ChuyX3/WTDesigner/DISEÑO Y SIMULACIÓN DE UN AEROGENERADOR DE BAJA POTENCIA (SWT)_2.docx

# DISEÑO Y SIMULACIÓN DE UN AEROGENERADOR DE BAJA POTENCIA (SWT)

## Resumen

La creciente tendencia en la instalación de turbinas eólicas de baja potencia en zonas urbanas ha creado un pequeño mercado para la industria y la investigación. En este documento se presenta el estudio energético para el diseño de un pequeño aerogenerador de uso urbano/doméstico. El diseño está basado según el estándar IEC 61400-2, de tipo de eje horizontal de álabes fijos con una potencia nominal de 5kW. Para la realización del análisis energético se utiliza el software de simulación TRNSYS con una base de datos del clima de diferentes zonas del país.

## Palabras Clave

Aerogenerador, SWT, Diseño, Optimización, Simulación, ANSYS, TRNSYS

## Nomenclatura

P_t | Potencia de salida del aerogenerador
P_w | Potencia total contenida en el viento
C_p | Coeficiente de potencia
ρ | Densidad del aire ( ≈1.225(kg)/(m^3) )
R | Radio del rotor
v | Velocidad del viento
λ | Razón de velocidad de la punta
ω_t | Velocidad angular del rotor
rpm | Velocidad angular del rotor en RPMs
v_u | Velocidad tangencial del rotor
v_r | Velocidad relativa del viento vista por el perfil alar
θ | Ángulo de ataque del viento relativo
α | Ángulo de ataque del perfil alar
β | Ángulo de control o “pitch”
L | Longitud local de cuerda
C_t | Torque mecánico suministrado al rotor

## I. INTRODUCCIÓN

En los últimos años ha habido un notable crecimiento en la instalación de aerogeneradores de baja potencia, con una capacidad de generación global de 830MW para finales del 2014 según [1]. También se estima que para el 2020 haya una capacidad instalada de 2000MW. Esta tendencia crea un pequeño mercado para la industria e investigación de pequeños aerogeneradores (SWT).

Sin embargo, en México hay un bajo desarrollo de esta tecnología. Según el informe del Programa de Desarrollo del Sistema Eléctrico Nacional (PRODESEN 2018) [2] nos indica que en México se ubican 45 centrales eólicas cuya capacidad instalada alcanza los 4,199 MW que representa el 6% de la capacidad total instalada, y que para el 2017 generaron un 3% del total nacional (10,620 GWh). A pesar de esto México tiene un potencial estimado de energía eólica de más de 40,000 MW considerando un factor de capacidad de 20-25% como lo indica la SENER [3], con lo cual podemos concluir que hay una gran capacidad de desarrollo para esta tecnología en nuestro país.

Algunas de las problemáticas presentes en los SWT son la ausencia en la optimización de los costos, deficiencia en la conversión eléctrica, pocos cuidados en la optimización del peso, cargas de diferentes naturalezas experimentadas por los SWT, álabes poco optimizados debido a seguir tendencias de los grandes aerogeneradores [4].

Un factor que también es importante para los SWT es que son diseñados para una velocidad de viento fija, a diferencia de los grandes aerogeneradores que tienen un control de “Pitch”, esto provoca que la mayoría del tiempo no opere en las condiciones de diseño, bajando así su rendimiento [5].

Otro problema que presentan es un bajo coeficiente de potencia ( C_p ) debido a un bajo rendimiento aerodinámico consecuencia de un bajo número de Reynolds. Los C_p para estos aerogeneradores es de alrededor de <(0.46-0.48) para un buen diseño de rotor, en contraposición a un C_p >0.50 para HAWT de gran tamaño (MWs) [6].

Con este trabajo se busca mejorar el coeficiente de potencia de un SWT en base a la optimización del álabe. Esto se pretende lograr mejorando el rendimiento aerodinámico por medio de cálculos matemáticos, así como optimizando el peso al utilizar materiales compuestos en la fabricación.

Este trabajo consta de cuatro etapas, la primera es el diseño geométrico por medio análisis matemático, la segunda es el diseño estructural con la ayuda de software CAD, la tercera es un análisis de elemento finito de tipo CFD y uno estático-estructural, y por último un análisis energético con ayuda de simulación.

## II. METODOLOGÍA

### II.1 Modelo Matemático.

La energía mecánica producida por el aerogenerador se puede calcular por la siguiente función [7]:

P_t =1/2∙C_p ∙ρ∙π∙R^2 ∙v^3

La razón entre la velocidad de la turbina y la velocidad del viento es expresad por lo siguiente [7]:

λ=(ω_t ∙R)/v

La velocidad tangencial del álabe está dada por la relación [8]:

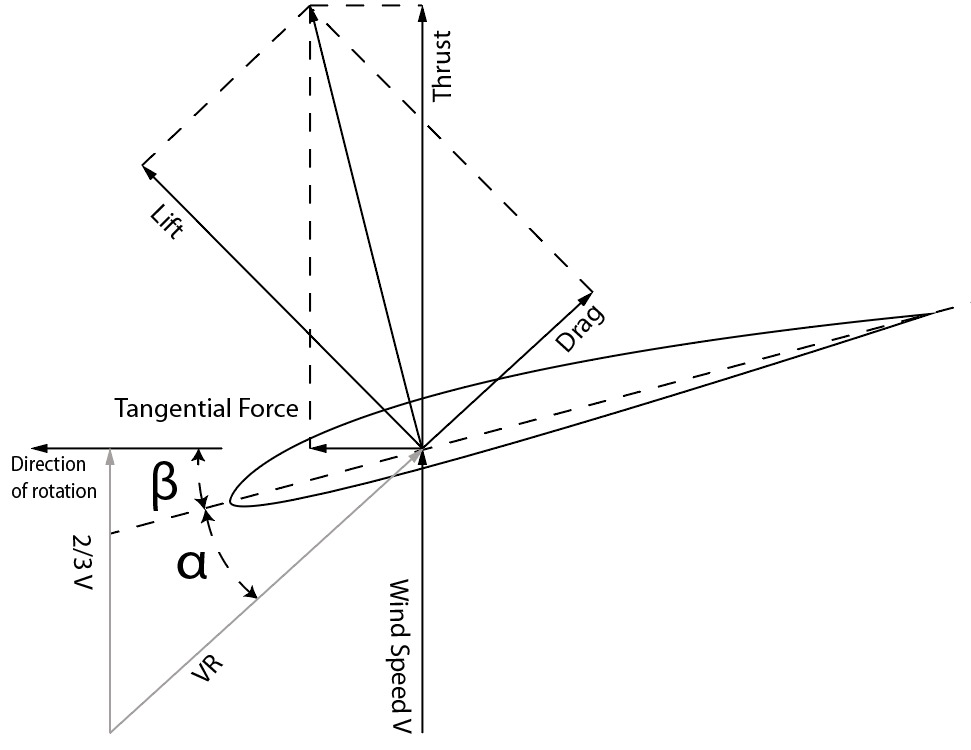
[picture p1: figure]

Figura 1: Fuerzas aerodinámicas actuando sobre un perfil alar.

v_u =(rpm∙π∙R)/30

La velocidad del viento vista desde el punto de vista del perfil alar está dada por [8]:

v_r =√((2/3v)^2 +v_u ^2)

A un ángulo de ataque [8]:

θ=tan^(-1) 2/(3λ)

El ángulo de ataque del perfil alar está dado por:

α=θ-β

Donde hay un β para cada punto a lo largo del álabe.

Para determinar las fuerzas aerodinámicas que actúan sobre el álabe es necesario obtener las gráficas de coeficiente de sustentación aerodinámica y coeficiente de arrastre del perfil alar. Para nuestro caso se utilizó el perfil alar A18.

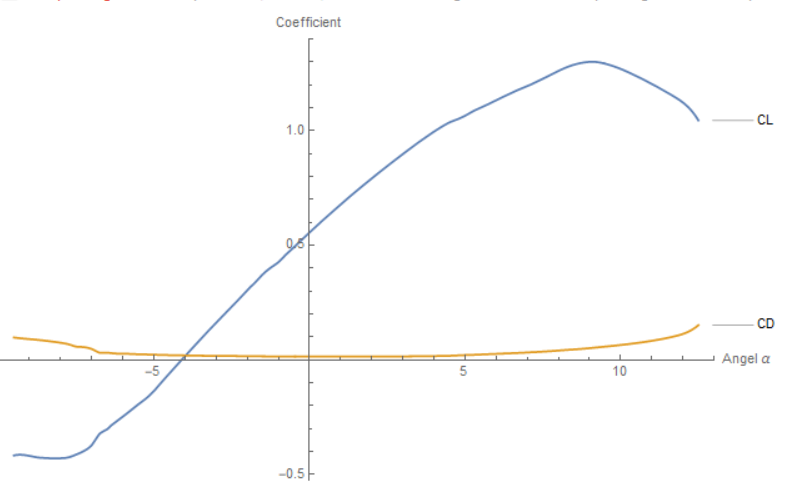
[picture p2: figure]

Gráfica 1: Coeficiente de sustentación aerodinámica (azul) y coeficiente de arrastre aerodinámico (amarillo) del perfil alar A18 para un número de Reynolds de 100,000 [9].

Para cada sección del álabe de longitud dr , hay una fuerza en dirección del viento relativo y una fuerza ortogonal, como lo muestra la figura 1, definidas por [10]:

F_(lift) =1/2C_L ∙ρ∙v_r ^2 ∙L∙dr

F_(drag) =1/2C_D ∙ρ∙v_r ^2 ∙L∙dr

Estas dos fuerzas pueden combinarse para obtener dos principales componentes, una ortogonal al plano de barrido y otra en dirección a la rotación.

F_(tangential) =F_(lift) ∙Sin(α)- F_(drag) ∙Cos(α)

F_(thrust) =F_(lift) ∙Cos(α)+ F_(drag) ∙Sin(α)

Para obtener el torque suministrado al rotor se tiene la siguiente expresión [10]:

C_t =∫_0^R (F_(tangential) ∙r) dr

Sustituyendo las ecuaciones anteriores de fuerzas en nuestra expresión de torque nos queda que:

C_t =ρ/2∫_0^R v_r ^2 L(C_L Sin(α)- C_D Cos(α))r dr

Donde v_r , L y α están en función de r (distancia de la sección del álabe al eje de rotación) y, C_L y C_D en función de α .

De igual manera se tiene que el empuje es:

Thrust=ρ/2∫_0^R v_r ^2 L(C_L Cos(α)+ C_D Sin(α))r dr

El cual se convierte en una carga dinámica estructural que debe ser considerada en el diseño mecánico.

Para obtener la potencia de salida se utiliza la siguiente ecuación [10]:

P_t =C_t ω_t

Para obtener el C_P se divide la potencia de salida por la potencia total contenida en el viento.

C_P =(P_t)/(P_w)

### II.2 Teoría de Elemento de Álabe (BET)

La teoría de momento de elemento de álabe es un método ampliamente utilizado y rápido en aplicaciones aerodinámicas y aeroelásticas de aerogeneradores. Por medio de este método se puede calcular rápidamente las fuerzas aerodinámicas que actúan sobre el álabe dividiéndolo en un número de secciones finitas de longitud dr y analizarlas independientemente [11][12].

De esta manera se puede definir la función del momento como:

C_t =ρ/2∑_(k=1)^n v_r ^2 L(C_L Sin(α)- C_D Cos(α))r dr

Donde:

n=número de secciones

dr=R/n

r=k dr

En base a esta ecuación podemos calcular analíticamente una aproximación de una curva idealizada de generación de energía en función de la velocidad del viento.

Para realizar el programa que se encarga de la resolución de las ecuaciones se ha utilizado el software matemático “Wolfram Mathematica”.

Cálculo de las secciones del álabe
Cálculo de la razón de velocidad para cada sección
Cálculo de la velocidad tangencial para cada sección
Cálculo de la velocidad relativa del viento para cada sección
Cálculo del ángulo de ataque para la mayor fuerza tangencial
Cálculo del ángulo del viento relativo para cada sección
Cálculo del ángulo de control (pitch) para cada sección
Cálculo de la longitud de cuerda para cada sección

Diagrama de Flujo 1: Secuencia utilizada por el programa en Mathematica para calcular los parámetros de la geometría del álabe

### II.3 Diseño CAD

En el diseño basado en características, se crean modelos de piezas. Para rediseñar una parte, se editan las características; sus descripciones se modifican y registran automáticamente por la interfaz de diseño y se compilan en serie por un compilador de diseño (operaciones de edición de características CAD). Los sistemas de modelado paramétrico basados en características generalmente definen modelos por un historial secuencial de pasos de modelado. Cada paso contiene operaciones y parámetros. Un modelador paramétrico es un sistema para el diseño geométrico que preserva no solo el objeto diseñado, sino también el conjunto de gestos constructivos utilizados para diseñarlo [13].

Para realizar el diseño del álabe se utiliza CATIA V5 el cual es un sistema CAD basado en características.

Primeramente se crean una serie de costillas con la geometría del perfil alar con una longitud de cuerda, ángulo y posición obtenidos en el cálculo matemático. Posterior mente se hace una superficie muilti-sección la cual será necesaria para el laminado de compuestos. Con esta superficie se crea un sólido que será utilizado en el análisis aerodinámico CFD.

### II.4 Diseño del Laminado de Compuestos

### II.5 Método De Elemento Finito (FEM)

#### II.5.1 Análisis CFD

Otro método para calcular el rendimiento de un aerogenerador es la dinámica de fluidos computacional (CFD). Dado que se espera que los modelos aerodinámicos de baja fidelidad como la teoría BEM sigan siendo el método de elección para los cálculos de carga industrial en el futuro previsible, los modelos numéricos de mayor fidelidad como la dinámica de fluidos computacional (CFD) se utilizan cada vez más para investigar fenómenos aerodinámicos relevantes para rotores grandes [14].

El CFD consiste en la solución numérica de las ecuaciones de control diferenciales de los flujos de fluidos con la ayuda de computadoras[15][16].

En el mercado hay una gran variedad de software para resolver estos cálculos, uno de ellos es ANSYS 19 CFX el cual es utilizado para este caso.

#### II.5.2 Análisis Estático-Estructural

Para realizar el análisis estático estructural se utilizará el método de elemento finito (FEM) con ayuda de la herramienta de software ANSYS 19.

Para realizar este análisis primeramente se carga la geometría en un sistema de análisis ACP(Pre) en una plantilla de trabajo de Workbench, en el cual se cargarán los laminados de compuesto.

En la misma plantilla de Workbench se carga un análisis estático estructural para definir las cargas y soportes. La carga se importa desde el análisis anterior CFD. El soporte es uno fijo al extremo del álabe.

Por último se agrega un análisis ACP(Post) donde se mostrarán los resultados del análisis estructural. Para ello hay que agregar dos soluciones, “Deformación” y “Factor de Seguridad” con criterio de máximo esfuerzo.

### II.6 Análisis Energético

TRNSYS es un entorno de simulación completo y extensible para el modelado transitorio de sistemas, incluidos edificios multizona. Es utilizado por ingenieros e investigadores de todo el mundo para validar nuevos conceptos de energía, desde simples sistemas de agua caliente doméstica hasta el diseño y simulación de edificios y sus equipos, incluyendo estrategias de control, comportamiento de los ocupantes, sistemas de energía alternativa (eólica, solar, fotovoltaica, sistemas de hidrógeno), etc.[17].

Para una simulación efectiva, la estructura modular de TRNSYS requiere la identificación de los componentes del sistema aplicables. Los componentes en el sistema TRNSYS se conocen como TYPE. Cada TYPE tiene un conjunto de parámetros independientes del tiempo, así como entradas variables en el tiempo que permiten la estimación de las salidas coincidentes.

Para este trabajo se utilizaron los siguientes types con el objetivo de simular el desempeño del aerogenerador que se está diseñando:

#### Type 90:

Es un modelo matemático para un sistema de conversión de energía eólica (WECS). El modelo calcula la salida de potencia de un WECS según una característica de potencia frente a la velocidad del viento (proporcionada en forma de tabla en un archivo externo). También se modela el impacto de los cambios de densidad del aire y los aumentos de velocidad del viento con la altura.

Las principales ecuaciones utilizadas en este modelo se basan en el trabajo de (Quinlan, 2000; Quinlan et al., 1996) [17].

#### Type 15:

Este componente sirve para leer datos a intervalos de tiempo regulares de un archivo de datos meteorológicos externos, los interpola (incluida la radiación solar para superficies inclinadas) en intervalos de tiempo de menos de una hora, y los pone a disposición de otros componentes de TRNSYS [17].

#### Type 65:

El componente de gráficos en línea se usa para mostrar las variables del sistema seleccionadas mientras la simulación avanza.

Este componente es altamente recomendado y se usa ampliamente, ya que proporciona información variable valiosa y permite a los usuarios ver inmediatamente si el sistema no está funcionando como se desea. Las variables seleccionadas se mostrarán en una ventana de trazado separada en la pantalla [17].

#### Type 24:

Este componente integra una serie de cantidades durante un período de tiempo. Cada integrador de cantidades puede tener hasta, pero no más de 500 entradas. Type24 puede reiniciarse periódicamente a lo largo de la simulación, ya sea después de un número específico de horas o después de cada mes del año [17].

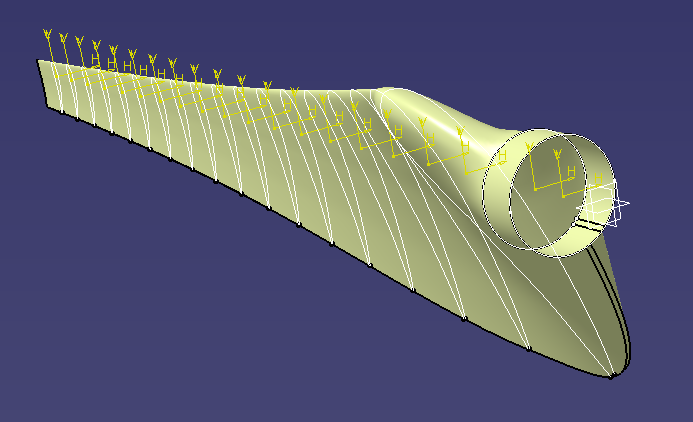
[picture p3: figure]

Figura2: Modelo del álabe creado en CATIA V5.

## III. RESULTADOS

### III.1 Diseño Geométrico y Análisis Matemático

Los parámetros de diseño utilizados para calcular la geometría de álabe se muestran en la tabla 1.

Parámetro | Valor | Descripción
P_D | 5kW | Potencia de salida
v_w | 10m/s | Velocidad del viento
Z | 3 | Número de álabes
ω_D | 200 RPM | Velocidad angular del rotor
N | 20 | Número de secciones para el BEM

Tabla 1: Parámetros de diseño para el rotor.

Los primeros datos arrojados por el programa son el radio del rotor R=2.55m y la razón de velocidad de la punta λ= 5.34 . Los datos de longitud de cuerda y ángulo giro (twist) se muestran en las gráficas 2 y 3.

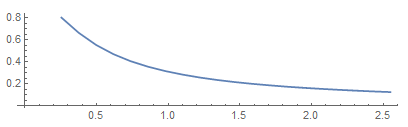
[picture p4: figure]

Gráfica 2: Gráfica de longitud de cuerda a lo largo del álabe.

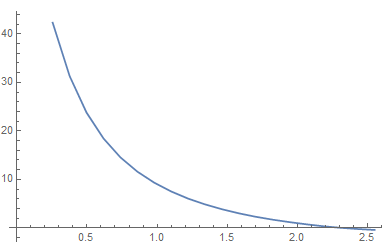
[picture p5: figure]

Gráfica 3: Gráfica de ángulo de control (pitch) a lo largo del álabe.

Con estos datos se pudo construir el álabe en CATIA V5. Primeramente se crearon las costillas con el perfil alar y las dimensiones (longitud de cuerda y ángulo) calculadas y después una superficie multisección.

### III.2 Análisis De Elemento Finito

## IV. CONCLUSIONES

## REFERENCIAS

[1] http://www.sener.gob.mx/res/PE_y_DT/pub/2014/Prospectiva_Energias_Reno_13-2027.pdf
[2] Energía, S. (2018). Programa de Desarrollo del Sistema Eléctrico Nacional. Retrieved from https://www.gob.mx/sener/acciones-y-programas/programa-de-desarrollo-del-sistema-electrico-nacional-33462.
[3] Secretaría de Energía (SENER). (2013). Prospectiva de Energías Renovables 2013–2027, SENER, México.
[4] Bukala J, Damaziak K, Kroszczynski K, Malachowski J, Szafranski T, Tomaszewski M, Karimi H, Jozwik K, Karczewski M & Sobczak K. (2016). Small Wind Turbines: Specification, Design, and Economic Evaluation. Wind Turbines (Chapter 4). Rijeka: IntechOpen.
[5] Battisti L, Benini E, Brighenti A, Dell’Anna S & Raciti Castelli M. (2018). Small wind turbine effectiveness in the urban environment. Renewable Energy. Volume 129, Part A. pp 102-113
[6] Probst O, Martínez J, Elizondo J & Monroy O. (2011). Small Wind Turbine Technology. 10.5772/15861.
[7] Mefteh W. (2018). Simulation-Based Design:Overview about related works, Mathematics and Computers in Simulation. Volume 152, Pages 81-97, ISSN 0378-4754.
[8] Renouard H & Hau E. (2006). Wind Turbines Fundamentals, Technologies, Application, Economics. Dipl.-Ing. Frühlingstraße 21KraillingGermany: Springer.
[9] http://airfoiltools.com/airfoil/details?airfoil=a18-il
[10] Rosales P. (2014). Estudio de un aerogenerador de baja capacidad en condiciones de arranque. Universidad Autónoma de México. Mexicali, B.C., México.
[11] C.R. Vogel, R.H.J. Willden, G.T. Houlsby, Blade element momentum theory for a tidal turbine, Ocean Engineering, Volume 169, 2018, Pages 215-226, ISSN 0029-8018.
[12] Faisal Mahmuddin, Rotor Blade Performance Analysis with Blade Element Momentum Theory, Energy Procedia, Volume 105, 2017, Pages 1123-1129, ISSN 1876-6102.
[13] Farjana S & Han S. (2018). Mechanisms of Persistent Identification of Topological Entities in CAD Systems: A Review. Alexandria Engineering Journal. ISSN 1110-0168
[14] Dose B, Rahimi H, Herráez I, Stoevesandt B & Peinke J. (2018). Fluid-structure coupled computations of the NREL 5 MW wind turbine by means of CFD. Renewable Energy. Volume 129, Part A. pp 591-605. ISSN 0960-1481
[15] A Mekhail T, Abdel-Fadeel W & Mohammed W. (2015). Experimental and CFD of Designed Small Wind Turbine. International Journal of Scientific and Engineering Research. 6.
[16] Arteaga-López E, Ángeles-Camacho C & Bañuelos-Ruedas F. (2019). Advanced methodology for feasibility studies on building-mounted wind turbines installation in urban environment: Applying CFD analysis. Energy. Volume 167. PP 181-188. ISSN 0360-5442
[17] Reference Manual. (n.d.). Trnsys 17, 4. Trnsys 17. (n.d.), 2.
