ChuyX3/WTDesigner/Protocolo de Tesis Presentación.pptx

## DISEÑO Y ANÁLISIS DE UN ÁLABE UTILIZANDO MATERIALES COMPUESTOS PARA UN AEROGENERADOR DE USO DOMÉSTICO

UNIVERSIDAD AUTÓNOMA DE BAJA CALIFORNIA
FACULTAD DE INGENIERÍA

Presenta: Ing. Jesús Ángel Rocha Morales

Director: Dr. Alexis Acuña Ramírez
Co-Director: Mtro. Omar Alejandro Mata Lucero

Diciembre 2018

## Resumen

En este trabajo se presenta el estudio matemático, estructural y energético para el diseño de un álabe para un pequeño aerogenerador (Small Wind Turbine: SWT) de uso doméstico y sub-urbano.

1

## Contexto Global

En los últimos años ha habido un notable crecimiento en la instalación de aerogeneradores de baja potencia, con una capacidad de generación global de 830MW para finales del 2014 según [1].
También se estima que para el 2020 haya una capacidad instalada de 2000MW. Esta tendencia crea un pequeño mercado para la industria e investigación de pequeños aerogeneradores .

## Problemática Energética

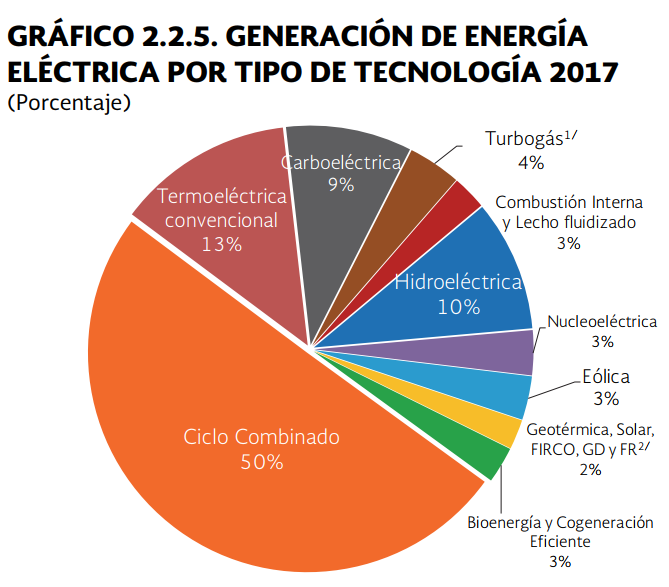
[picture p6: figure]

Fuentes de energía en México para el año 2018 [4].

- Estudios realizados por el Laboratorio de Energías Renovables del Departamento de Energía de Estados Unidos, CFE y varias instituciones mexicanas han estimado un potencial eólico de más de 40,000 MW en México, distribuido a lo largo de la península de Baja California, la región central, la costa del Golfo, la península de Yucatán y el istmo de Tehuantepec [2].
- La energía eólica es una de las alternativas más factibles en el corto y mediano plazo [2].
- A pesar de esto México ha instalado menos energía eólica en comparación con otros países de América del Norte [3].

2

## Problemática

Aerodinámica: Álabe mal optimizado que a menudo utiliza tendencias y observaciones de HAWT grandes, problema mal abordado de la abundancia de los recursos eólicos locales.
Bajo rendimiento aerodinámico por bajo número de Reynolds (<100,000) causa directa de bajo coeficiente de potencia (Cp<0.46-0.48) comparado con los grandes aerogeneradores (Cp > 0.50)
Estructural: diferente naturaleza de las cargas experimentadas por los SWT, poca atención a la optimización del peso;
Conversión / control: rara vez se utilizan métodos de regulación activa, como el control de rpm para expandir el margen operativo de los SWT, se presta poca atención a la capacidad de potencia mecánica de la turbina con la de un generador.
Económico: falta de costos optimizados de SWTs

## Objetivo general

- Diseñar un perfil alar con materiales compuestos para un pequeño aerogenerador por medio un análisis teórico y experimental.

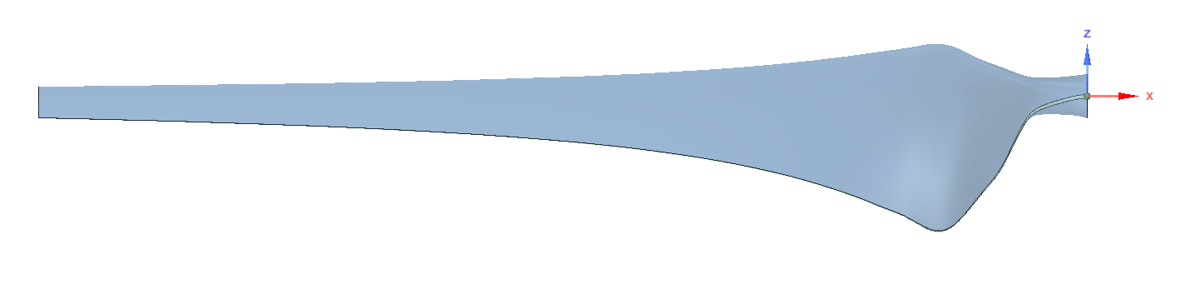
[picture p7: figure]

Álabe con perfil alar A18.

6

## Objetivos específicos

1
Investigar los diferentes perfiles alares más usuales en el mercado para los SWT, y los materiales para su fabricación.
2
Seleccionar los perfiles alares y materiales con los cuales se hará el análisis teórico y construcción del prototipo
3
Diseñar un álabe geométricamente optimizado

7

## Objetivos específicos

4
5
Análisis Energético
6
Análisis Estructural por elemento finito
Realizar un diseño estructural del álabe con materiales compuesto.

9

## Hipótesis

Con la selección correcta del perfil alar, un diseño matemáticamente optimizado y la utilización de materiales compuestos para el diseño de los álabes se puede mejorar el rendimiento de aerogeneradores de baja potencia SWT.

10

## Metodología

- Estudio del estado del arte de aerogeneradores.
- Estudio del estado del arte de perfiles alares.
- Estudio del estado del arte de materiales compuestos.
- Seleccionar los perfiles alares a los que se les hará el análisis teórico.
- Investigación sobre modelado matemático
- Investigación sobre herramientas de software para diseño y simulación
- Seleccionar los materiales a utilizar en el análisis teórico.
- Análisis teórico
- Construcción
- Experimentación
- Conclusiones

11

## Resultados: Uso de software

- Elemento Finito: ANSYS
  - Análisis estructural
  - Análisis térmico
  - Análisis de fluidos
  - Análisis modal
  - Análisis de fatiga
- CAD: Catia
  - Modelado 3D
- Matemáticas: Wolframe Mathematica
  - Cálculo de ecuaciones complejas y creación de plantillas
- Simulación Energética:
  - TRNSYS

## Resultados: Materiales Compuestos

- Propiedades en compuestos
  - Tienen una alta rigidez y resistencia específica orientadas a las fibras
  - La resistencia a la fatiga es mucho mayor para los materiales compuestos.
  - Ofrecen una alta resistencia a la corrosión.
  - Integración de piezas
  - Ofrecen mayores cantidades de flexibilidad de diseño
- Técnicas de Manofactura:
  - Hand Lay-up
  - Vacuum-bagging
  - Resin Infusion

## Resultados: Selección de Perfiles Alares

BW-3

- A18

SG6043

NACA6409

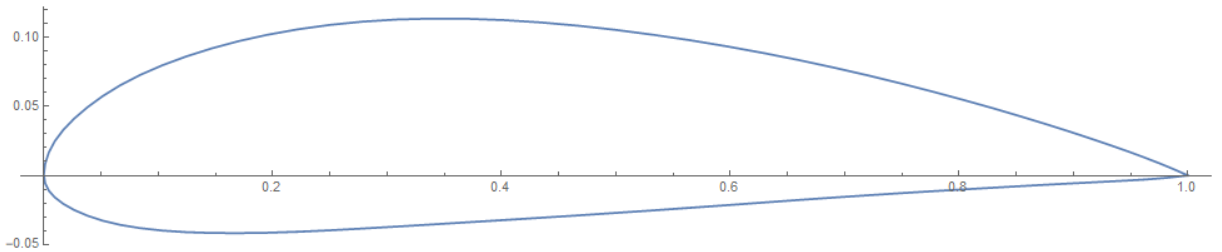
[picture p8: figure]

NACA4415

13

## Resultados: Diseño Matemático

- Modelo Matemático

Densidad del Aire: δ_a =1.225(Kg)/(m^3)

Potencia del Aire: Pw(v_W , R, C_P )= 1/2 C_P δ_a v_W ^3 R^2 π

Radio del Rotor: R (P_O , v_W , C_P )=√((2 P_O)/(C_P δ_a v_W ^3 π))

Razón de velocidad de la punta ( λ ): T SR(v_W , rpm, R)=(R rpm π)/(30 v_W)

Revoluciones Por Minuto: RPM (v_W ,λ, R)=(λ 30 v_W)/(R π)

## Resultados: Diseño Matemático

Modelo Matemático


Velocidades y fuerzas aerodinámicas

Velocidad Tangencial: v_U (R, rpm)= (R rpm π)/30

Velocidad Relativa: v_r (v_W , v_U )=√((2/3 v_W )^2 +v_U ^2)

Ángulo v_r (θ): theta(λ)=tan^(−1) 2/(3λ)

Longitud de la cuerda: ChordLength(R,v_W ,Z,C_L , λ,v_r )=(2 π R)/Z 8/(9 C_L) (v_W)/(λ v_r)

## Resultados: Diseño Matemático

Cálculos iniciales

v_W =15 m/s

P_O =5000W

R_1 =1.31 m
λ_d =6.86
Δ_R =0.0620526 m

RPM=750

Z=3

N_R =20

## Resultados: Diseño Matemático

Características del Álabe
A18

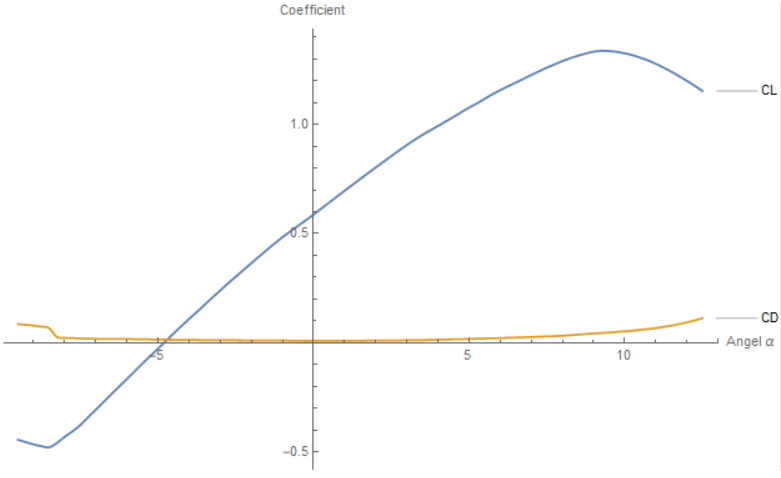
[picture p9: figure]

CL y CD en función del ángulo α

Coeficiente de sustentación: C_L (α)

Coeficiente de arrastre: C_D (α)

## Resultados: Diseño Matemático

Cálculo de los Parámetros de Diseño

R_(bls) =Table[x,{x, R −Δ_R (N_R −1),R,Δ_R }]
R_bls=Table[x,{x, R −Δ_R (N_R −1),R,Δ_R}]
λ_(rls) =(λ_d R_(bls))/R
λ_rls=(λ_d R_bls)/R
v_(uls) =v_u (R_(bls) , rpm)
v_uls=v_u (R_bls, rpm)
v_(rls) =v_r (v_w , v_(uls) )
v_rls=v_r (v_w, v_uls )
α_(ls) =FindMaximum(C_(FT) (α,λ_(rls) ), α)
α_ls=FindMaximum(C_FT (α,λ_rls ), α)
θ_(ls) =theta(λ_(rls) )
θ_ls=tℎeta(λ_rls )
θ_(ls) =θ_(ls) − α_(ls)
θ_ls=θ_ls − α_ls
l_(ls) =ChordLength(
R_(bls) ,v_W , Z, C_L (α_(ls) ),λ_(rls) ,v_(rls) )
l_ls=CℎordLengtℎ(
R_bls,v_W, Z, C_L (α_ls ),λ_rls,v_rls )

## Resultados: Diseño Matemático

Resultados de Diseño

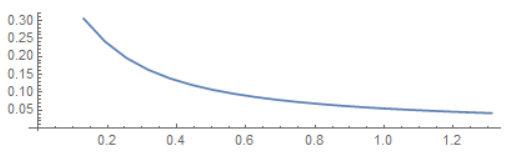
[picture p10: figure]

Gráfica de la longitud de cuerda

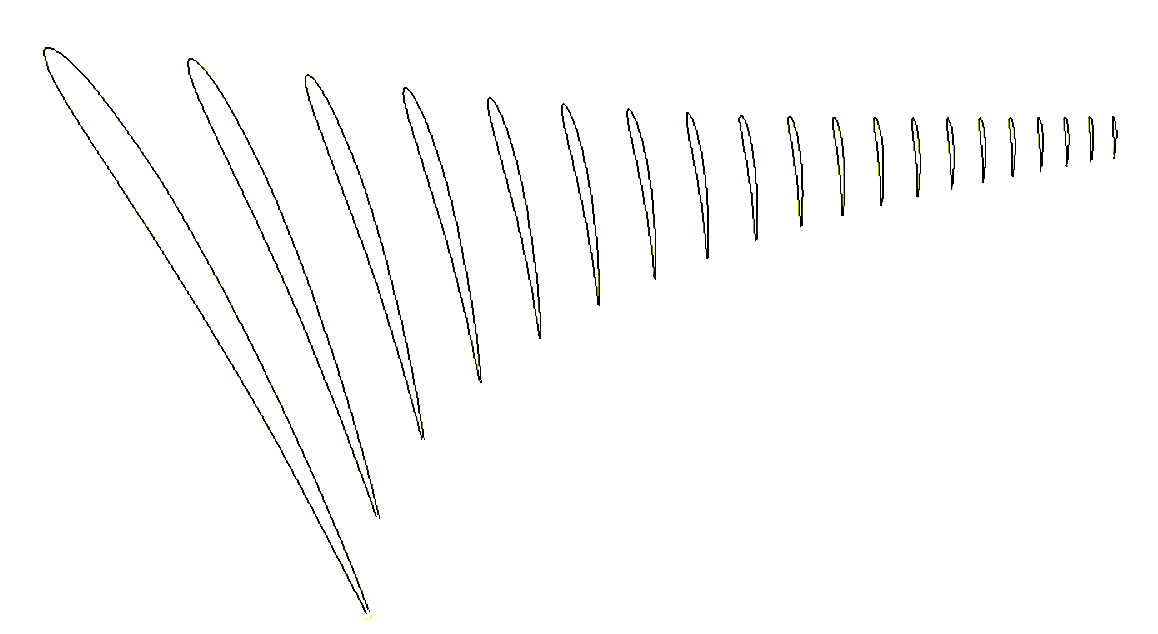
[picture p11: figure]

Perfil alar para cada longitud y ángulo calculado

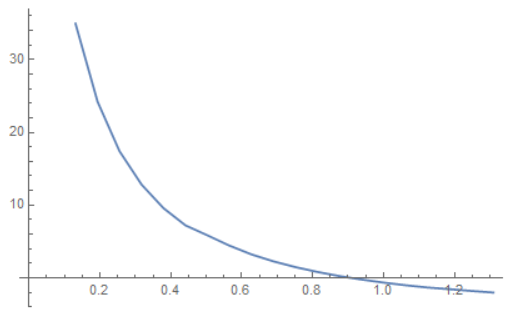
[picture p12: figure]

Gráfica del ángulo de control (Pitch)

## Resultados: Diseño Matemático

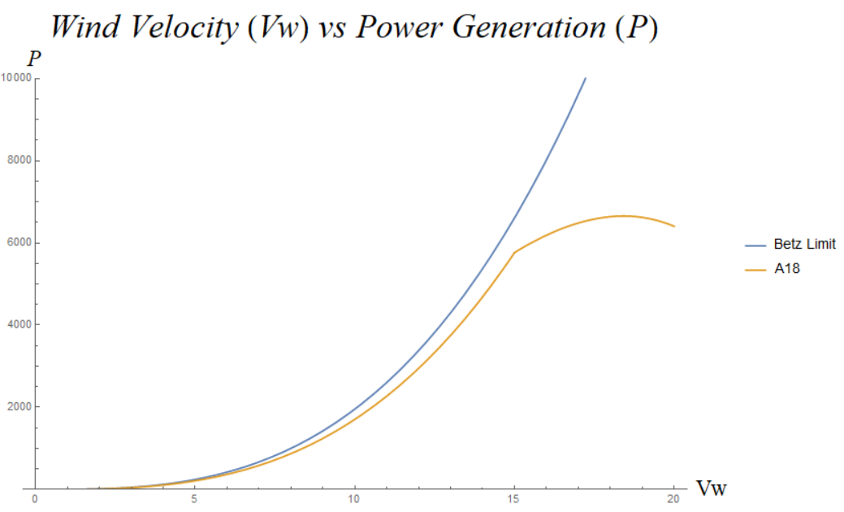
[picture p13: figure]

Fuerza Aerodinámica:
F_T (α,λ,v_r ,l, dr)= 1/2C_(FT) (α,λ)δ_a v_r ^2 l dr

Velocidad de viento contra Generación de potencia.

Resultados de Potencia

Potencia de Salida:
P_O (v_W )={(Zπ)/30RPM(v_W ) ∑ (F_T R_(b2) ),RPM(v_W )≤rpm_(max) (Zπ)/30rpm_(max) ∑ (F_T R_(b2) ),RPM(v_W )>rpm_(max) }

Coeficiente de Conversión de Potencia:
C_P (v_W )=P_O (v_W )/P_W (v_W ) = 0.516967

## Resultados: Diseño 3D

Modelado de Superficie

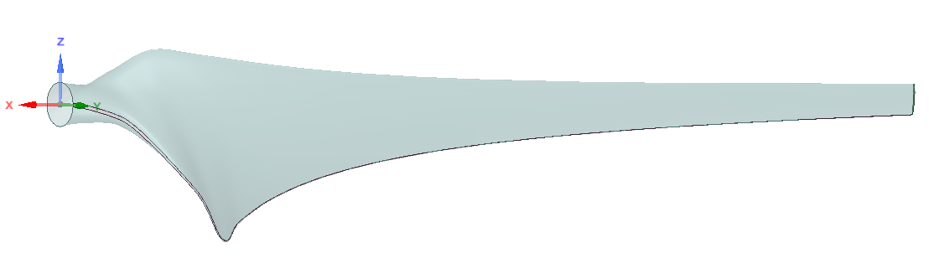
[picture p14: figure]

Diseño de superficie en CATIA.

## Resultados: Análisis Estructural

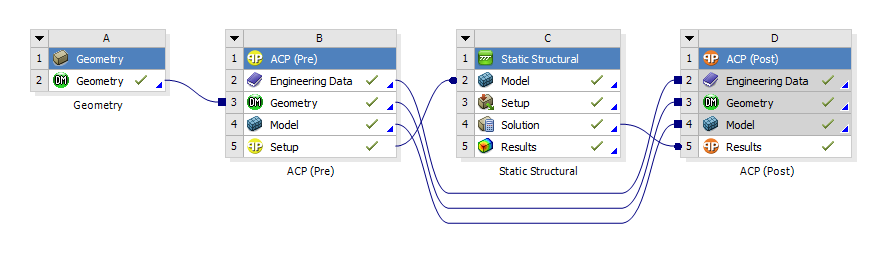
[picture p15: figure]

Hoja de trabajo en Workbench

Diagrama de Flujo del Análisis

## Resultados: Análisis Energético

ACP (Pre)

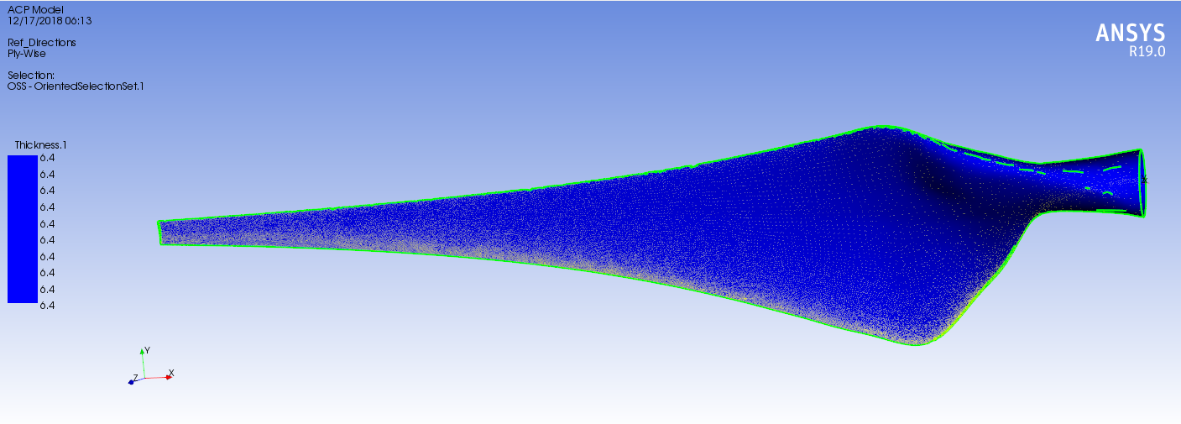
[picture p16: figure]

Diseño de superficie en CATIA.

## Resultados: Análisis Estructural

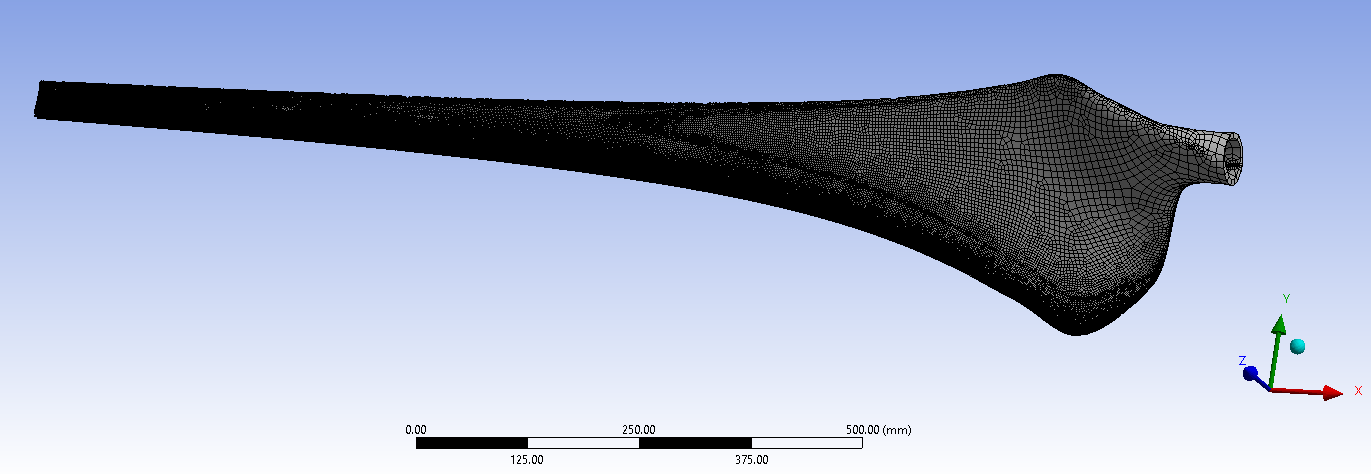
[picture p17: figure]

Mesh del álabe en Mechanical.

Static Structural

## Resultados: Análisis Estructural

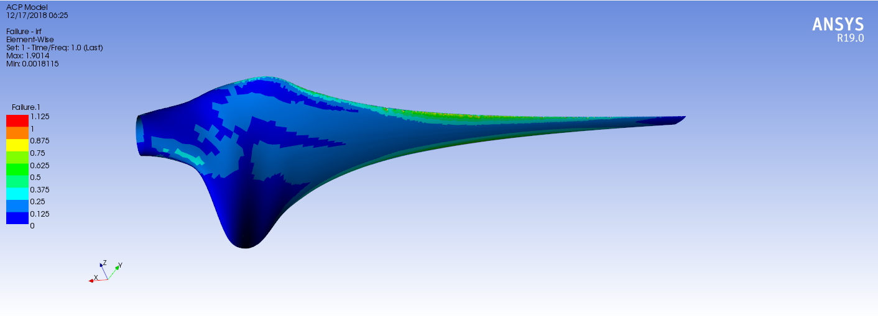
[picture p18: figure]

Diseño de superficie en CATIA.

ACP(Post)

## Resultados: Análisis Energético

TRNSYS

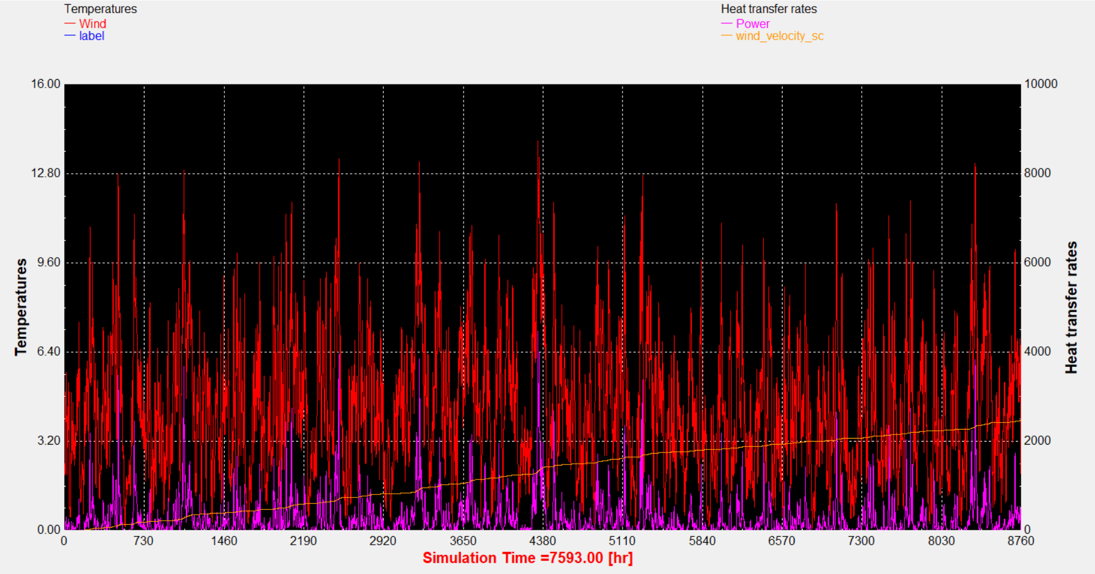
[picture p19: figure]

Diseño de superficie en CATIA.

2474kW Anual

## Resultados: Análisis Energético

TRNSYS

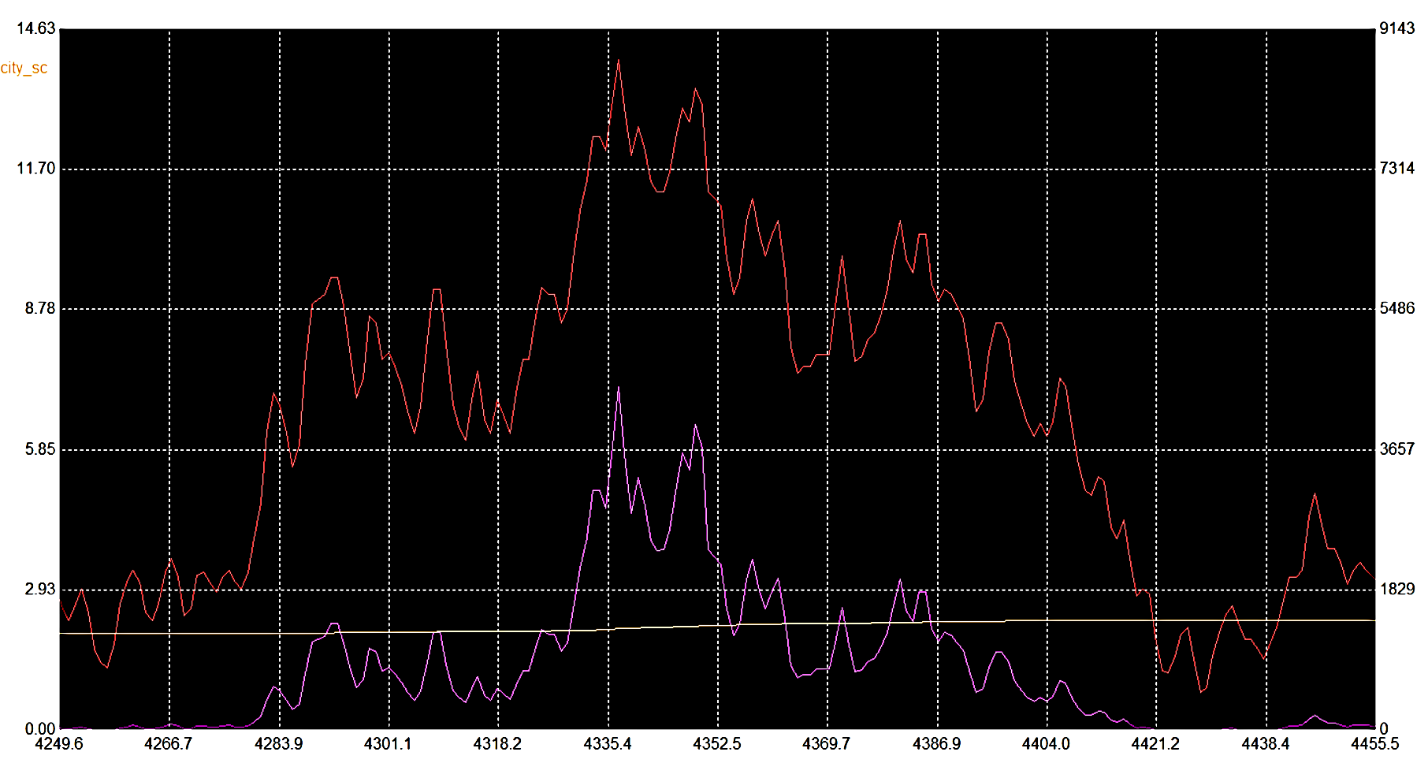
[picture p20: figure]

Diseño de superficie en CATIA.

13.97 m/s

4.454kW

5.338kW

CP = 0.4947

## Cronograma

Actividad | 17-2 | 18 - 1 | 18 -2 | 19 - 1 | Descripción
Estado del arte de aerogeneradores | X | X | | | Hacer una búsqueda de los aerogeneradores disponibles en el mercado
Estado del arte de materiales compuestos | X | X | | | Hacer una investigación acerca de los materiales compuestos disponibles en el mercado para la construcción del perfil alar
Estado del arte de perfiles alares | X | X | | | Hacer una investigación acerca de los perfiles alares disponibles en el mercado
Selección los perfiles alares | | X | x | | Seleccionar los perfiles alares a los que se les hará el análisis teórico
Investigación sobre modelado matemático | | X | X | | Hacer una investigación acerca de los métodos utilizados para el modelado matemático y cálculo de esfuerzos a los que se ve sometido el perfil alar
Investigación sobre herramientas de software | | X | X
Selección de materiales | | X | x | | Se seleccionarán los materiales a los cuales se les harán las pruebas de simulación

## Cronograma

Actividad | 17-2 | 18 - 1 | 18 -2 | 19 - 1 | Descripción
Análisis teórico | | X | X
Construcción | | | X | | Construcción de un prototipo de un perfil alar
Experimentación | | | x | X
Conclusiones | | | | X | Corroborar los resultados obtenidos en el análisis teórico por medio de la comparación con los resultados obtenidos en la experimentación
Artículo | | | | X | Desarrollar un artículo de divulgación
Tesis | | | X | X | Desarrollar trabajo de tesis

## Referencias

- [1] WWEA Small Wind World Report 2016. World Wind Enegy Association, Germany (2016).
- [2] Yoreley Cancino-Solórzano, Antonio J. Gutiérrez-Trashorras, Jorge Xiberta-Bernat, Current state of wind energy in Mexico, achievements and perspectives, In Renewable and Sustainable Energy Reviews, Volume 15, Issue 8, 2011, Pages 3552-3557, ISSN 1364-0321.
- [3] Q. Hernández-Escobedo, R. Saldaña-Flores, E.R. Rodríguez-García, F. Manzano-Agugliaro, Wind energy resource in Northern Mexico, In Renewable and Sustainable Energy Reviews, Volume 32, 2014, Pages 890-914, ISSN 1364-0321.
- [4]Energía, S. (2018). Programa de Desarrollo del Sistema Eléctrico Nacional. Retrieved from https://www.gob.mx/sener/acciones-y-programas/programa-de-desarrollo-del-sistema-electrico-nacional-33462
- [5]Bukala, J., Damaziak, K., Kroszczynski, K., Malachowski, J., Szafranski, T., Tomaszewski, M., Karimi, H., Jozwik, K., Karczewski, .M & Sobczak, K.. (2016). Small Wind Turbines: Specification, Design, and Economic Evaluation. En Wind Turbines(Chapter 4). Rijeka: IntechOpen.
- [6] Probst, Oliver & Martínez, Jaime & Elizondo, Jorge & Monroy, Oswaldo. (2011). Small Wind Turbine Technology. 10.5772/15861.
- [7] http://airfoiltools.com/
- [8] Hau, E.. (2006). Wind Turbines: Fundamentals, Technologies, Economics. New York: Springer.

## Muchas gracias por su atención
