ChuyX3/WTDesigner/airfoil.jpeg

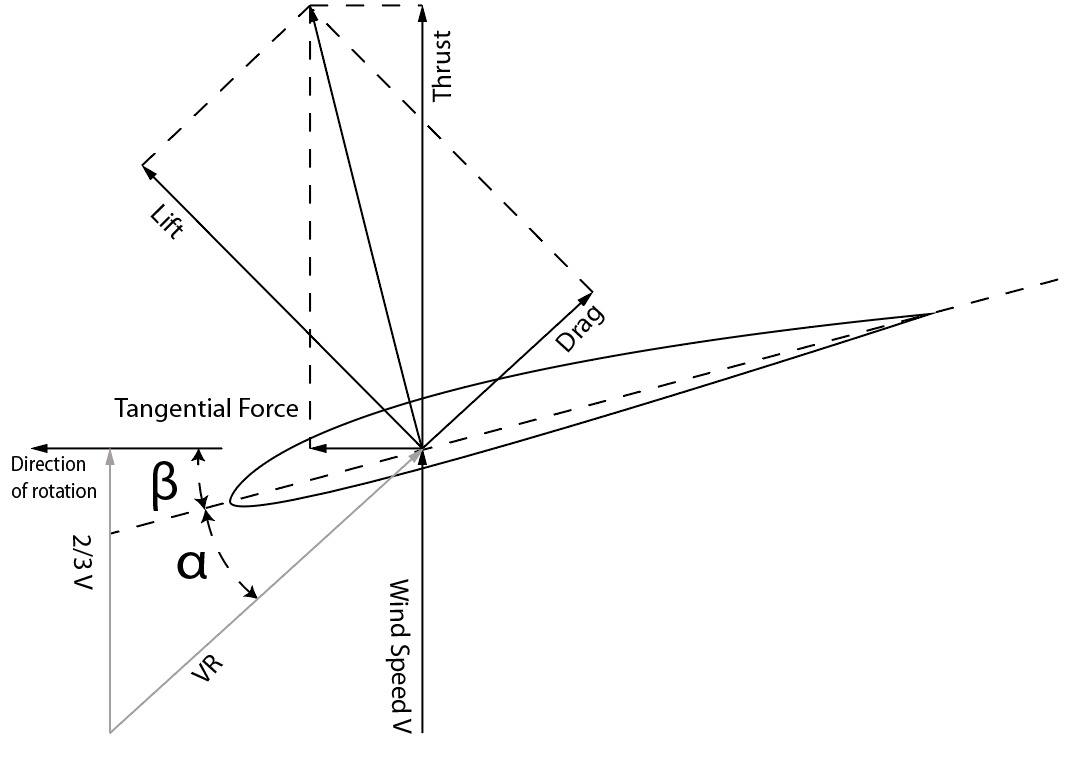
airfoil.jpeg
