ChuyX3/WTDesigner/A18/airfoil.DXF

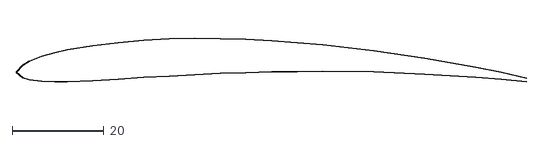
[picture p22: CAD file, 2018-12-04]
A18/airfoil.DXF
111.0 x 9.40
