ChuyX3/WTDesigner/A18/geometry2/AirfoilShape.igs

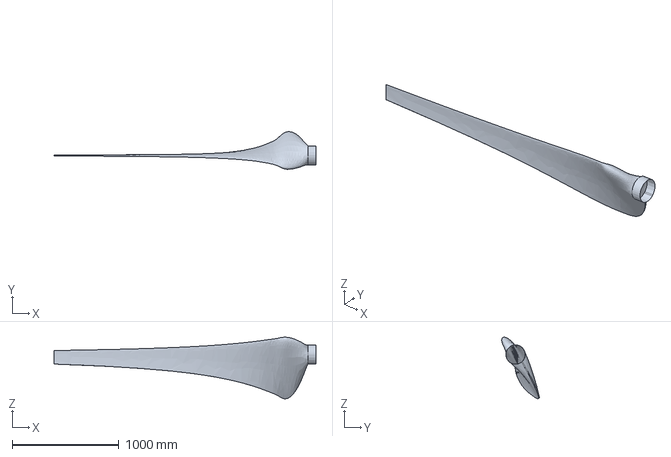
[picture p23: CAD file, 2018-12-19]
A18/geometry2/AirfoilShape.igs
2450.0 x 352.6 x 576.7 mm
