ChuyX3/WTDesigner/A18/geometry/AirfoilSolid.igs

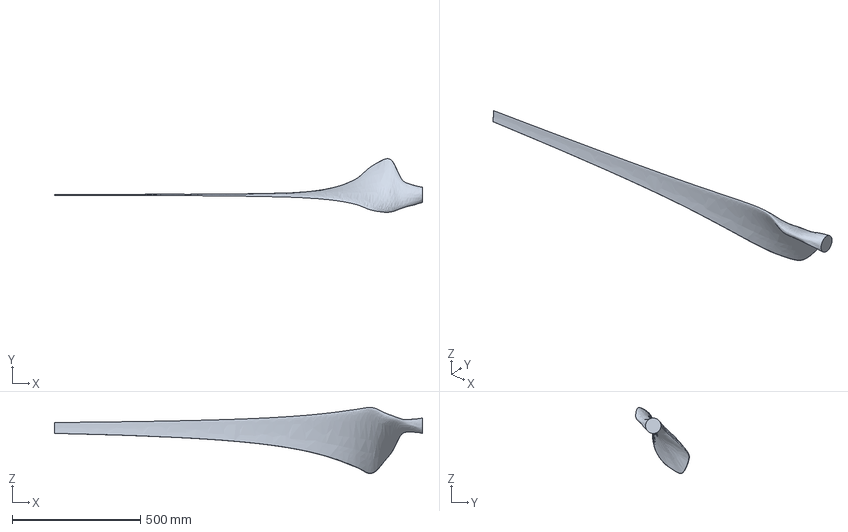
[picture p24: CAD file, 2018-12-17, an earlier design]
A18/geometry/AirfoilSolid.igs
1432.0 x 209.0 x 257.1 mm
