ChuyX3/WTDesigner/(list of files, cad)

Other CAD files:
A18/geometry2/AirfoilSolid.igs
A18/geometry/AirfoilShape.igs
A18/geometry/Airfoil.CATPart
A18/geometry/AirfoilRibs.CATPart
A18/geometry/AirfoilShape.CATPart
A18/geometry/AirfoilSolid.CATPart
A18/geometry2/Airfoil.CATPart
A18/geometry2/AirfoilRibs.CATPart
A18/geometry2/AirfoilShape.CATPart
A18/geometry2/AirfoilSolid.CATPart
