ChuyX3/WTDesigner/(commit log)

2018-12-04 + creating repository
    [Airfoil.CATPart, AirfoilRibs.CATPart, AirfoilShape.CATPart, AirfoilShape.igs, AirfoilSolid.CATPart, AirfoilSolid.igs, airfoil.DXF, design_data.xls]
2018-12-19 * update
    [Airfoil.CATPart, AirfoilRibs.CATPart, AirfoilShape.CATPart, AirfoilShape.igs, AirfoilSolid.CATPart, AirfoilSolid.igs, design_data.xls, force_data.xls]
